Erandurthil/CNCproject/Original Design/README.md

# CNCproject
This is a Marlin-firmware based CNC machine
Has a sturdy design made from 3D printed parts and 20 x 20mm aluminum extrusions.
In combination with Nema 23 motors, and reliable custom Marlin firmware, this machine is very powerful.
