Erandurthil/CNCproject/Original Design/Buying List.xlsx

TOOLS |  |  | Different tools you will need (but might not need to buy)
Soldering iron |  |  | Soldering iron is required for most electronics
Multimeter |  |  | To controll voltages, connections and
5, 3, 2.5 and 1.5mm hex wrench |  |  | 5mm hex for M6 x 40/50 bolts, 3mm hex for M5 x 10 bolts, 2.5mm hex for M3 screws, 1.5 mm hex for grub screws
small flat head screwdriver |  |  | to fasten elecronics and more.
phillips head screwdriver |  |  | optional
6mm and 5mm drill bit |  |  | 6mm drillbit To drill holes in 20 x 20 aluminum extrusion for M6 x 50mm bolts. 5mm drillbit to drill holes in base plywood board for M5 screws screws.
Electronic Screwdriver |  |  | for use with 5 and 6mm drillbit
M6 tap |  |  | to tap M6 threads in the square section of 550mm 20 x 20mm aluminum extrusions
WHEN ASSEMBLING THE MACHINE
HIGH VOLTAGE!!! |  |  | Assemble everything before you connect any phase current to the electonics. Double check all connections with a multimeter.
Dont over tighten bolts and nuts |  |  | If bolts are over tightened 3D printed parts might crack!
Patience |  |  | A lot a waiting and focus is required.
Determiation |  |  | All will work out with determination.
Warm bevrage |  |  | Take a break. Don't work when you´re tired.
WHEN CUTTING WITH THE MACHINE
Hearing protection |  |  | For extended working sessions <10 minutes always wear hearing protection or you might damage your hearing
Eye protection |  |  | Being close to the machine increases the risk of dangerous debris damaging your eyes, very important when working with aluminum.
Protective gloves |  |  | When your cut is done you will want to remove your part carefully in order to avoid potential splinters from the working material.
Vaccum cleaner |  |  | to capture dust and splinters when cutting.
PARTS
Component | Amount | Amount of items | Used on the machine… |  | Suggested Seller/Website EU | Price/item | Sum
 | from link | on used the machine
FRAME
20x20mm aluminum extrusion 550mm | 6 | 6 | Frame, two parallell with the Y axis, four parallell with X axis like a ladder |  | https://www.banggood.com/Machifit-Black-2020-V-Slot-Aluminum-Profile-Extrusion-Frame-for-CNC-Laser-Engraving-Machine-p-1341703.html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 | 7.53 | 45.18
20x20mm aluminum extrusion 600mm | 2 | 2 | Mounts as support on the X axis gantry |  | https://www.banggood.com/Machifit-Black-2020-V-Slot-Aluminum-Profile-Extrusion-Frame-for-CNC-Laser-Engraving-Machine-p-1341703.html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 | 8.35 | 16.7
20x20mm aluminum extrusion 100mm | 4 | 4 | Legs to mount under the frame |  | https://www.banggood.com/Machifit-Black-2020-V-Slot-Aluminum-Profile-Extrusion-Frame-for-CNC-Laser-Engraving-Machine-p-1341703.html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 | 3.45 | 13.8
 |  |  |  |  |  |  | 0
MOVEMENT |  |  |  |  |  |  | 0
Nema 23 stepper motor | 1 | 3 | Two drive the Y axis, one drives the X axis. 3A motor is preferable over lower current variants. |  | https://www.amazon.de/-/en/Stepperonline-Pieces-Stepper-Bipolar-Printers/dp/B07CPP9RDP | 75 | 75
Nema 17 stepper motor | 1 | 1 | Drives Z axis through bevel gears |  | https://www.amazon.de/Usongshine-Stepper-Motor-1-8%C2%B04-Printer/dp/B07GLMGQB3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 | 10.98 | 10.98
600mm Leadscrew (8mm lead, 2mm pitch) | 2 | 2 | Used with nema 23 steppers to drive the Y axis |  | https://www.amazon.de/-/en/SIENOC-100-000-3D-Printer-Type/dp/B07LDZF2YR | 13.99 | 27.98
700mm Leadscrew (8mm lead, 2mm pitch) | 1 | 1 | Used with nema 23 stepper to drive the X axis |  | https://www.amazon.de/-/en/SIENOC-100-000-3D-Printer-Type/dp/B07LDZDBYV | 14.99 | 14.99
200mm Leadscrew (2mm lead, 2mm pitch) | 1 | 1 | Z axis leadscrew |  | https://www.amazon.de/-/en/WEJUANR-Printer-Lead-Screw-Pitch/dp/B08L98253X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 | 15.36 | 15.36
T8 Anti backlash nut (8mm lead, 2mm pitch) | 2 | 3 | Used to eliminate backlash in the machine. 3D printed parts are not designed to use included springs, |  | https://www.amazon.de/-/en/Dollatek-Spielfeder-Spring-Loaded-Elimination-Threaded/dp/B07DK58ZJP | 5.99 | 11.98
 |  |  | but the included nuts have tighter tolerances than those included with the (8mm lead) leadscrews |  |  |  | 0
Linear rail 200mm | 2 | 2 | Z axis linear movement, uses four linear blocks |  | https://www.banggood.com/Machifit-MGN12-100-1000mm-Linear-Rail-Guide-with-MGN12H-Linear-Sliding-Guide-Block-CNC-Parts-p-1156260.html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 | 13.49 | 26.98
Linear rail 600mm | 2 | 2 | X axis linear movement, uses four linear blocks |  | https://www.banggood.com/Machifit-MGN12-100-1000mm-Linear-Rail-Guide-with-MGN12H-Linear-Sliding-Guide-Block-CNC-Parts-p-1156260.html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 | 23.28 | 46.56
Linear rail 550mm | 2 | 2 | Y axis linear movement, uses four linear blocks |  | https://www.banggood.com/Machifit-MGN12-100-1000mm-Linear-Rail-Guide-with-MGN12H-Linear-Sliding-Guide-Block-CNC-Parts-p-1156260.html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 | 20.02 | 40.04
Linear block MGN12H | 6 | 6 | Additional linear blocks. One block is included with each linear rail mentioned above. 12 in total. |  | https://www.banggood.com/Machifit-MGN12-100-1000mm-Linear-Rail-Guide-with-MGN12H-Linear-Sliding-Guide-Block-CNC-Parts-p-1156260.html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 | 9.41 | 56.46
 |  |  |  |  |  |  | 0
ELECTRONICS |  |  |  |  |  |  | 0
ER11 500W Spindle and Power supply with speed governor | 1 | 1 | This is a very simple 500W Spindle which is used in this machine. Reliable and powerful enough for most materials. |  | https://www.banggood.com/Machifit-ER11-Chuck-CNC-500W-Spindle-Motor-with-52mm-Clamps-and-Power-Supply-Speed-Governor-p-1027937.html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 | 57.1 | 57.1
 |  |  | If you chose a different spindle for any reason the 3D printed 52mm clamp might not work. |  |  |  | 0
MKS GEN 1.4 motherboard | 1 | 1 | A reliable motherboard used with some 3D printers. Uses modified Marlin firmware. |  | https://www.amazon.de/-/en/Kingprint-Controller-Motherboard-RAMPS1-4-Compatible/dp/B079BZ1K3B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 | 29.99 | 29.99
TB6600 4A stepper motor driver | 4 | 4 | Takes power supply current and signals from MKS GEN 1.4 motherboard in order to drive all stepper motors |  | https://www.amazon.de/-/en/Haljia-TB6600-Stepper-Driver-Controller/dp/B06XQGHXL3 | 14.99 | 59.96
Mechanical endstops | 1 | 4 | The product linked has the correct dimensions for the 3D printed parts. |  | https://www.amazon.de/Longruner-Monitor-Display-Raspberry-Various/dp/B071J2RSY7 | 9.99 | 9.99
24V power supply | 1 | 1 | Provides current to the motherboard and the stepper motor drivers. 24V is preferable over 12V PSU |  | https://www.amazon.de/-/en/transformer-Meanwell-150-24-Inch-Switching-Transformer/dp/B00UCXHV6G | 20.68 | 20.68
80x80mm 24V/12V/5V fan | 1 | 1 | For cooling the enclosed motherboard. Buy two fans if you want to additional cooling to TB6600 drivers (Optional). |  | https://www.amazon.de/-/en/Sunon-MF80252V11000UA99-Fan-1-56-69-6/dp/B07ZBSD3HG | 8.87 | 8.87
C14 Appliance connector | 1 | 1 | A safe connector for mains current to connect to the machine. Size and dimensions may vary. |  | No link. Buy from local hardware store |  | 0
C14 Plug cable | 1 | 1 | A safe cable to connect to power outlet. 3m long. |  | No link. Buy from local hardware store |  | 0
 |  |  |  |  |  |  | 0
EXTRA CABLES |  |  | Some of the products include wires for motors and sensors, but extra wires are needed to complete the machine. |  |  |  | 0
3d Printer cable 4 pin-4 pin | 2 | 8m | Used to connect motors and sensors to the MKS GEN 1.4 board and the stepper motor drivers. Soldering is required. |  | https://www.amazon.de/-/en/UEETEK-Bipolar-Stepper-Printer-Machines/dp/B0711Z3RXJ | 6.99 | 13.98
Spindle motor cable | 0 | 4m | Any diameter cable larger or the size of the red and black spindle motor wires. |  | No link. Buy from local hardware store |  | 0
Cable management dragchains | 2 | 2m | Used to manage cables parallell to the X and Y axis. |  | https://www.amazon.de/-/en/Carrier-Energy-Printer-Router-Machine/dp/B07LDCQTBN | 9.59 | 19.18
 |  |  |  |  |  |  | 0
FASTNERS AND SCREWS |  |  |  |  |  |  | 0
M5 T-slot nut | 1 | ~50 | Used with bolts to fasten 3D printed parts to 20x20 aluminum extrusions |  | https://www.banggood.com/Drillpro-100pcs-M5-Hammer-Nut-Nickel-Plated-Carbon-Steel-Aluminum-Connector-T-Fastener-Sliding-Nut-p-1048442.html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 | 6.05 | 6.05
M5 x 10mm bolt | 1 | ~50 | Used with M5 T-slot nuts |  | https://www.banggood.com/Suleve-M5SH6-50Pcs-M5-Stainless-Steel-Hex-Socket-Button-Head-Screw-Bolt-8-30mm-Optional-Length-p-1333438.html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 | 4.48 | 4.48
M3 x 8mm bolt |  | 32 | Used with M3 T-slot nuts |  |  | 3.26 | 0
M3 T-slot nut | 1 | 32 | Used to fasten linear rails to 20x20 aluminum extrusions |  | https://www.banggood.com/Drillpro-50pcs-M3-T-Sliding-Nut-Zinc-Plated-Carbon-Steel-T-Sliding-Nut-for-2020-Aluminum-Profile-p-1081131.html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 | 5.38 | 5.38
M3 Square nut | 2 | ~30 | Used with 10/16/25mm M3 bolts to connect different 3D printed parts |  | https://www.amazon.de/-/en/SECCARO-Square-Stainless-Steel-Form/dp/B07NQN15KT?s=diy | 8.95 | 17.9
M3 x 10/16/25mm bolt | 1 | ~30 of each length | Used with square nuts | ALL M3 BOLTS YOU WILL NEED >>> | https://www.amazon.de/-/en/VIGRUE-Pack-1110-Screws-Washers/dp/B083R4PKBW | 26.99 | 26.99
M6 x 50mm bolt |  | 4 | To mount Y axis brackets to the frame M6 thread tapping required |  | No link. Buy from local hardware store
M6 x 40mm bolt |  | 4 | To mount X gantry extrusion clamp to 3D printed parts |  | No link. Buy from local hardware store
M6 nut |  | 4 | Used with M6 x 40 bolts |  | No link. Buy from local hardware store
M5 x 20mm bolt |  | 10 | Used to fasten Nema 23 motors to 3D printed parts |  | No link. Buy from local hardware store
M5 nut |  | 10 | Used with M5 x 20mm bolts |  | No link. Buy from local hardware store
M3 x 5mm grub screws |  | 12 | Used with 3D printed motor couplers and M3 square nuts to fasten Leadscrews to Nema 23 motors |  | No link. Buy from local hardware store
 |  |  |  |  |  |  | 682.56 | €
