Erandurthil/CNCproject/New Design/Printed Parts/Printed parts/Frame/System20_Bracket_20mm.stl

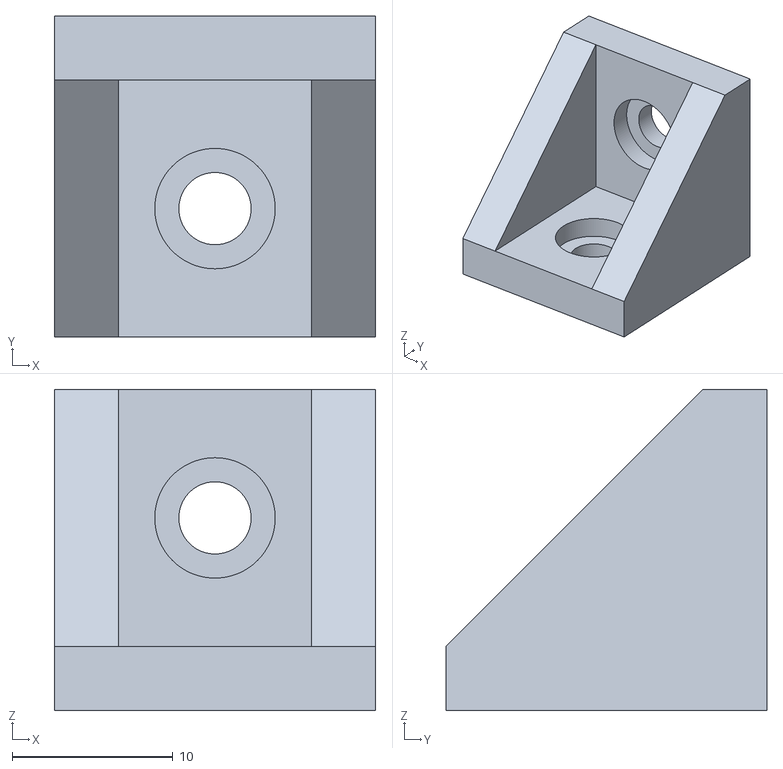
[picture p1: CAD file, 2021-01-12]
New Design/Printed Parts/Printed parts/Frame/System20_Bracket_20mm.stl
20.0 x 20.0 x 20.0
