Erandurthil/CNCproject/New Design/Printed Parts/Printed parts/X-axis/X_Z_MountingPlate.stl

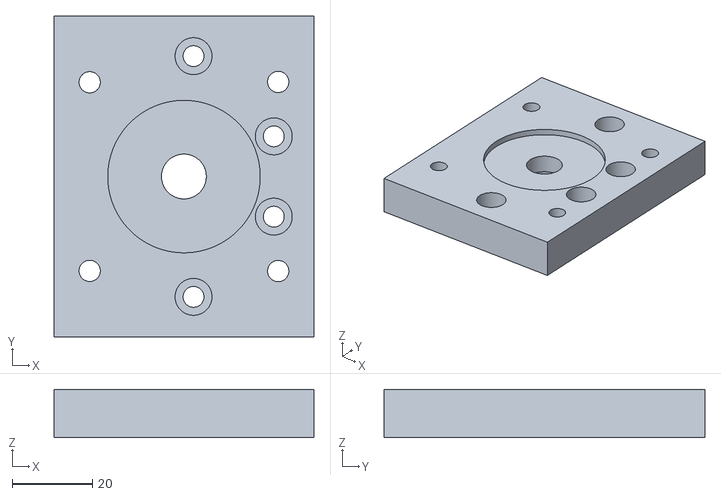
[picture p2: CAD file, 2021-02-13]
New Design/Printed Parts/Printed parts/X-axis/X_Z_MountingPlate.stl
64.8 x 80.0 x 12.0
