Erandurthil/CNCproject/New Design/Printed Parts/Printed parts/Y-axis/Y-axis Left side/Endstop_cover_L.stl

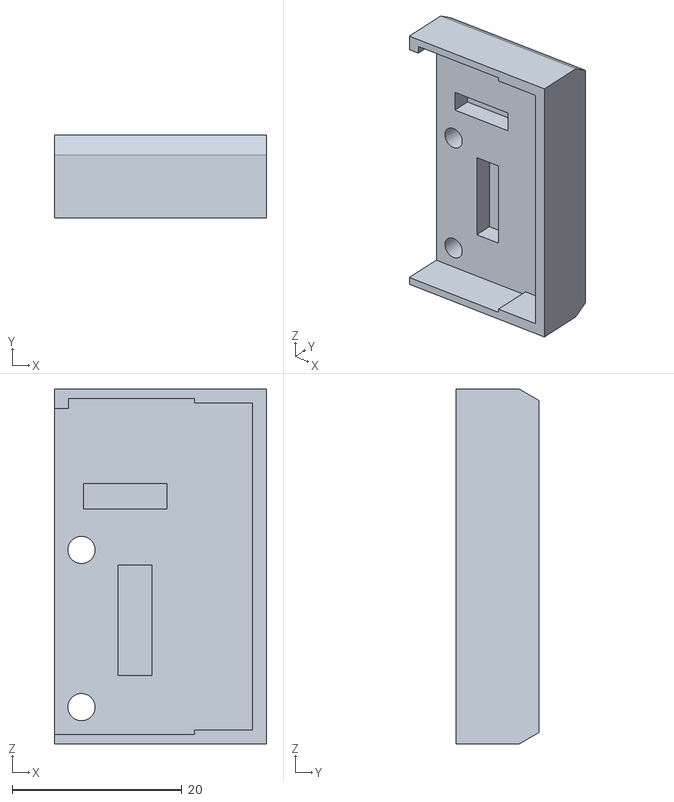
[picture p3: CAD file, 2021-02-13]
New Design/Printed Parts/Printed parts/Y-axis/Y-axis Left side/Endstop_cover_L.stl
25.0 x 9.80 x 41.8
