Erandurthil/CNCproject/New Design/Printed Parts/Printed parts/Y-axis/Y-axis Right side/Y_axis_front _bracket_R.stl

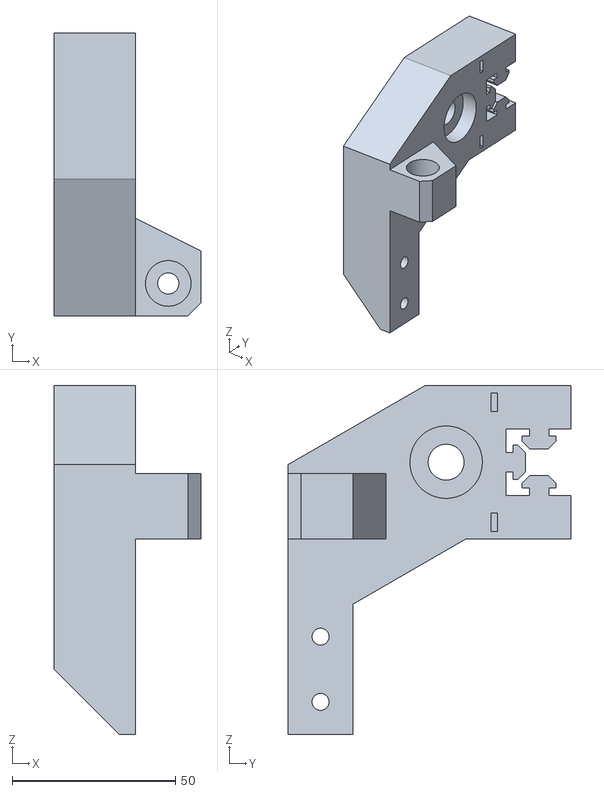
[picture p4: CAD file, 2021-02-13]
New Design/Printed Parts/Printed parts/Y-axis/Y-axis Right side/Y_axis_front _bracket_R.stl
45.0 x 86.8 x 107.0
