Erandurthil/CNCproject/New Design/Printed Parts/Printed parts/X-axis/Mounting Plate.stl

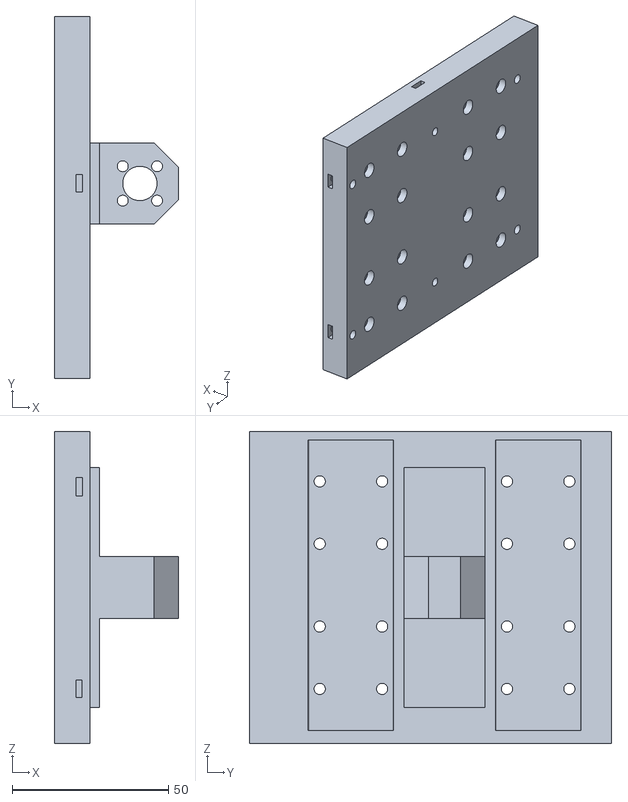
[picture p5: CAD file, 2021-02-12]
New Design/Printed Parts/Printed parts/X-axis/Mounting Plate.stl
39.8 x 116.0 x 100.0
