Erandurthil/CNCproject/New Design/Printed Parts/Printed parts/Y-axis/Y-axis Left side/Y_axis_motor_bracket_L.stl

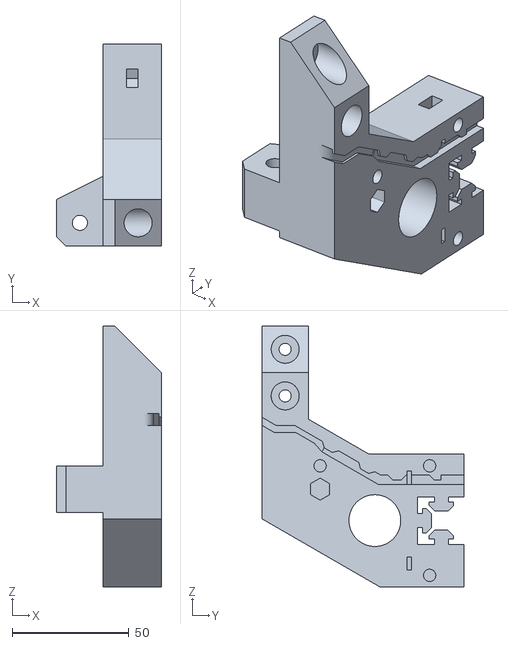
[picture p6: CAD file, 2021-02-13]
New Design/Printed Parts/Printed parts/Y-axis/Y-axis Left side/Y_axis_motor_bracket_L.stl
45.0 x 86.8 x 112.0
