Erandurthil/CNCproject/New Design/Printed Parts/Printed parts/Z-axis/5mm_D_shaft_bevel_gear.stl

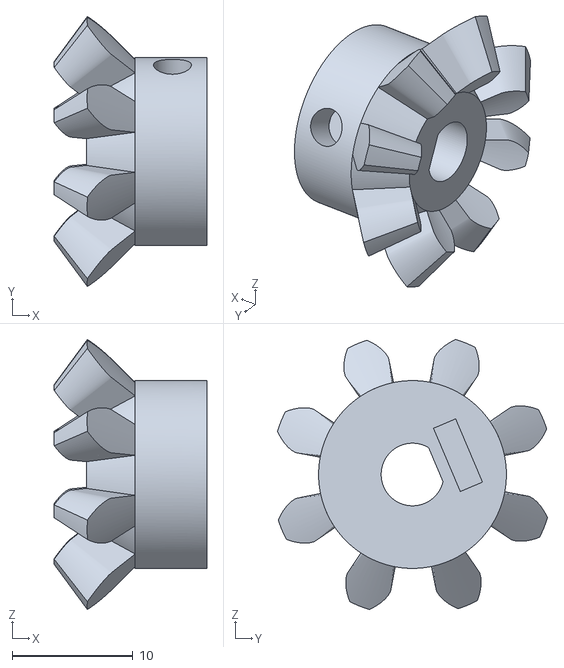
[picture p7: CAD file, 2021-01-12]
New Design/Printed Parts/Printed parts/Z-axis/5mm_D_shaft_bevel_gear.stl
12.7 x 22.4 x 22.4
