Erandurthil/CNCproject/New Design/Printed Parts/Printed parts/X-axis/X_axis_gantry_L.stl

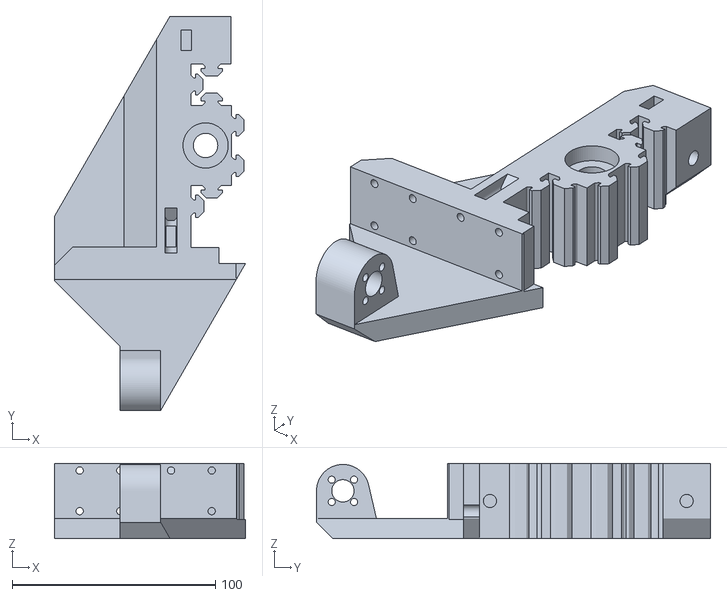
[picture p8: CAD file, 2021-01-12]
New Design/Printed Parts/Printed parts/X-axis/X_axis_gantry_L.stl
94.2 x 194.0 x 37.0
