Erandurthil/CNCproject/New Design/Printed Parts/Printed parts/Y-axis/Y-axis Left side/Y_axis_front_bracket_clamp.stl

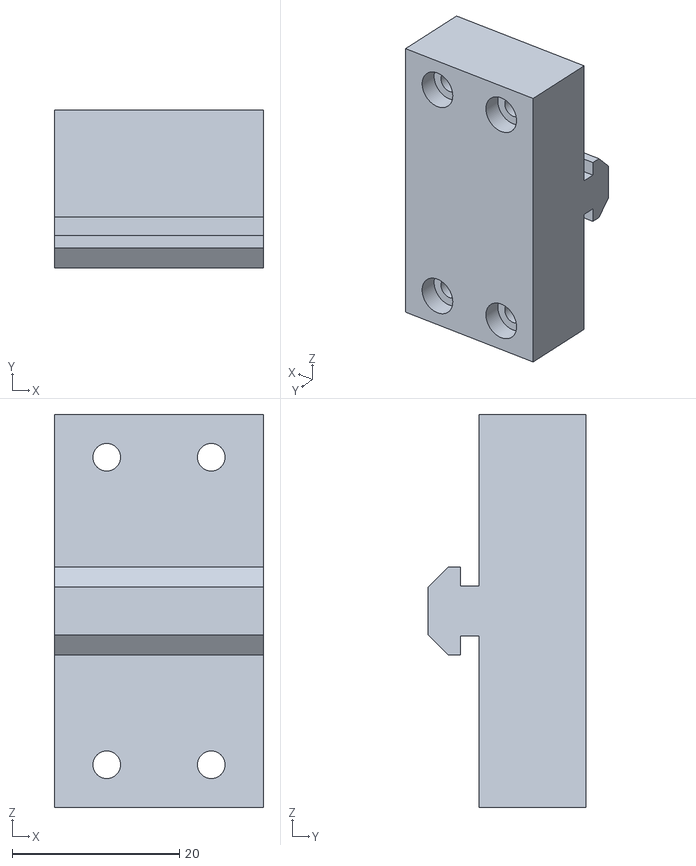
[picture p9: CAD file, 2021-02-13]
New Design/Printed Parts/Printed parts/Y-axis/Y-axis Left side/Y_axis_front_bracket_clamp.stl
25.0 x 18.9 x 47.0
