Erandurthil/CNCproject/New Design/Printed Parts/Printed parts/X-axis/Extrusion_clamp_R.stl

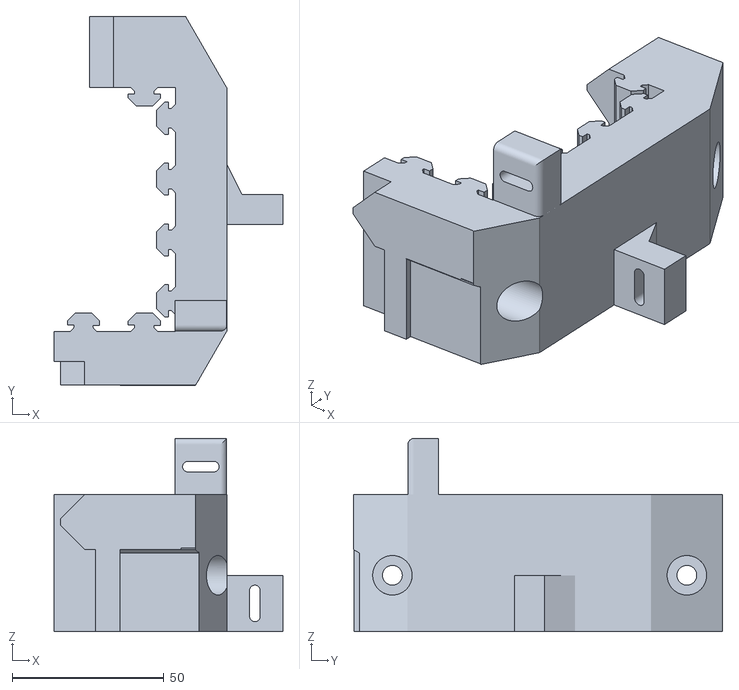
[picture p10: CAD file, 2021-01-12]
New Design/Printed Parts/Printed parts/X-axis/Extrusion_clamp_R.stl
75.3 x 121.4 x 63.5
