Erandurthil/CNCproject/New Design/Printed Parts/Printed parts/Y-axis/Y-axis Right side/Y_axis_motor_bracket_clamp_R.stl

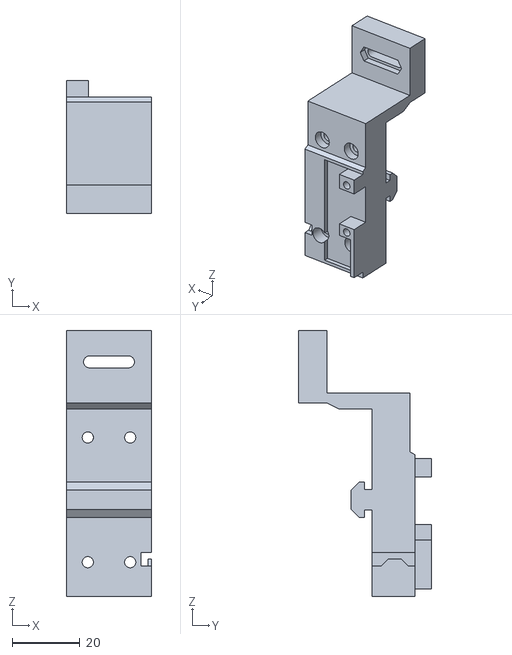
[picture p11: CAD file, 2021-02-13]
New Design/Printed Parts/Printed parts/Y-axis/Y-axis Right side/Y_axis_motor_bracket_clamp_R.stl
25.0 x 39.2 x 78.4
