Erandurthil/CNCproject/New Design/Printed Parts/Printed parts/Z-axis/Z_axis_motor_mount.stl

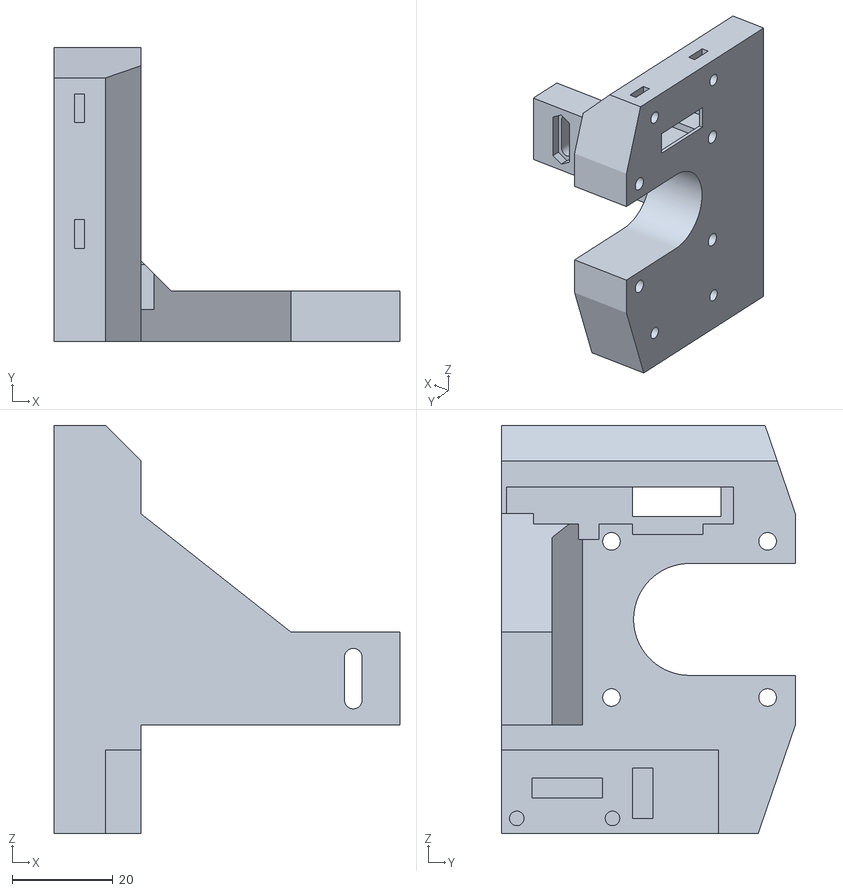
[picture p12: CAD file, 2021-01-12]
New Design/Printed Parts/Printed parts/Z-axis/Z_axis_motor_mount.stl
68.6 x 58.3 x 81.0
