Erandurthil/CNCproject/New Design/Printed Parts/Printed parts/X-axis/Extrusion_clamp_L.stl

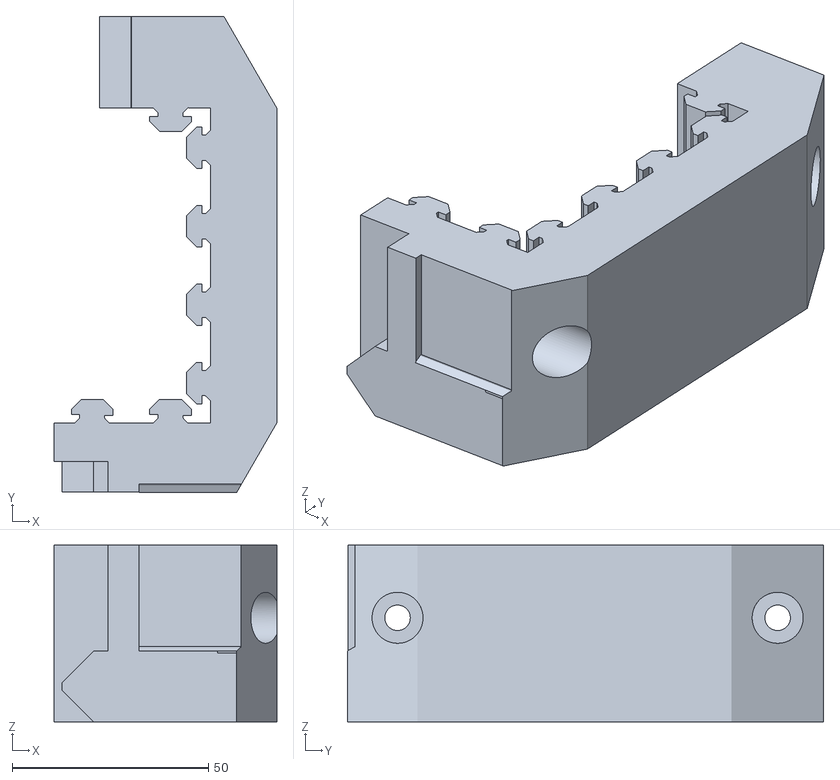
[picture p13: CAD file, 2021-01-12]
New Design/Printed Parts/Printed parts/X-axis/Extrusion_clamp_L.stl
56.8 x 121.4 x 45.0
