Erandurthil/CNCproject/New Design/Printed Parts/Printed parts/Y-axis/Y-axis Left side/Y_axis_motor_bracket_clamp_L.stl

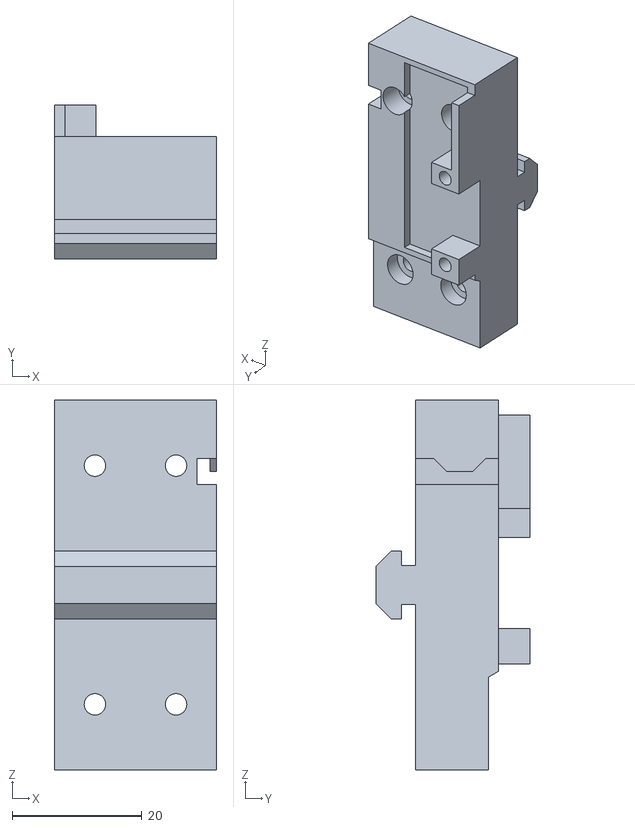
[picture p14: CAD file, 2021-02-13]
New Design/Printed Parts/Printed parts/Y-axis/Y-axis Left side/Y_axis_motor_bracket_clamp_L.stl
25.0 x 23.7 x 57.0
