Erandurthil/CNCproject/New Design/Printed Parts/Printed parts/Z-axis/Spindle_motor_mount.stl

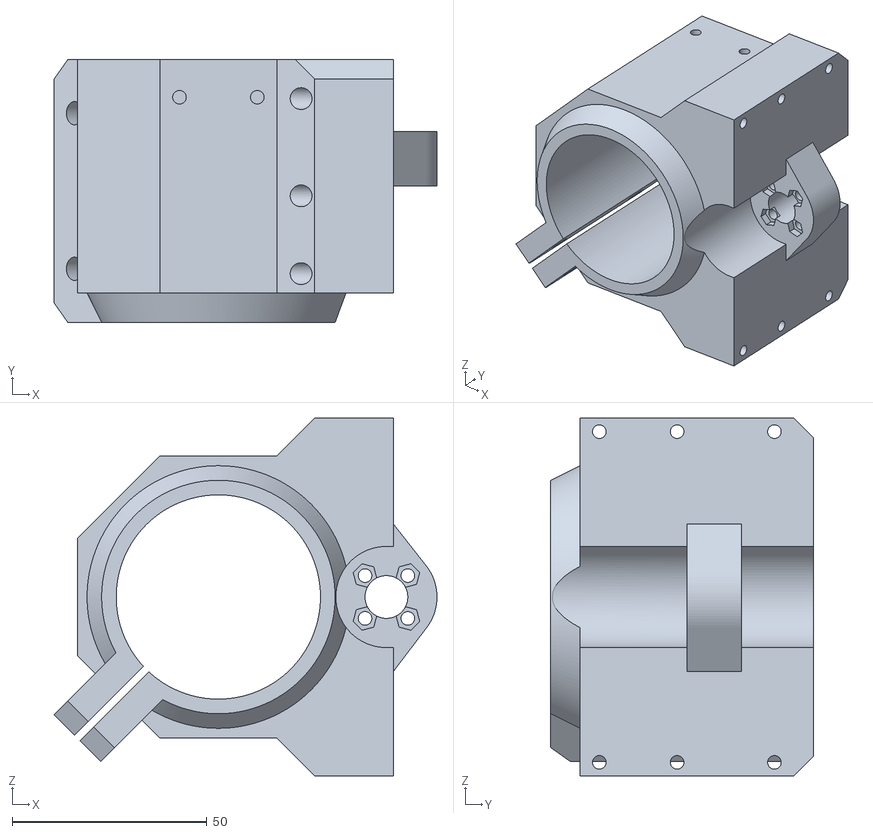
[picture p15: CAD file, 2021-01-12]
New Design/Printed Parts/Printed parts/Z-axis/Spindle_motor_mount.stl
98.4 x 67.5 x 92.0
