Erandurthil/CNCproject/New Design/Printed Parts/Printed parts/Y-axis/Y-axis Left side/Y_axis_spacer_L.stl

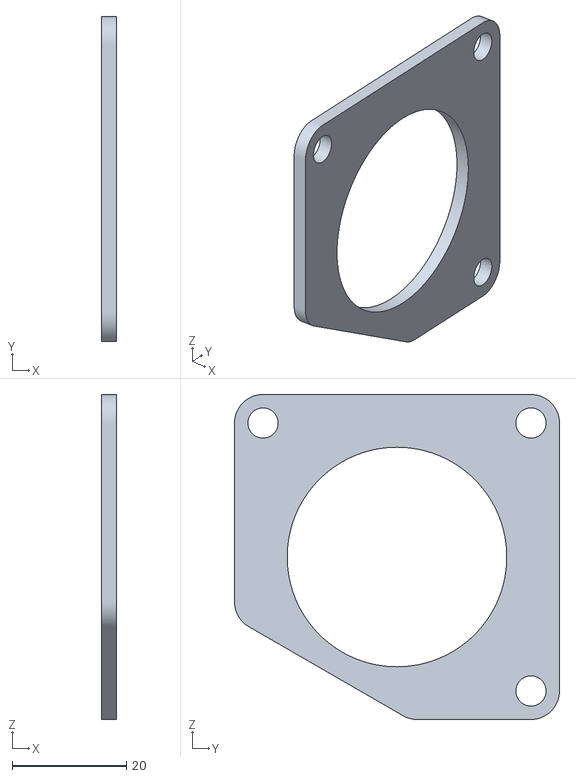
[picture p16: CAD file, 2021-01-12]
New Design/Printed Parts/Printed parts/Y-axis/Y-axis Left side/Y_axis_spacer_L.stl
2.60 x 57.0 x 57.0
