Erandurthil/CNCproject/(list of files, cad)

Other CAD files:
New Design/Printed Parts/Printed parts/Y-axis/Y-axis Right side/Endstop_cover_R.stl
New Design/Printed Parts/Printed parts/Y-axis/Y-axis Right side/Y_axis_motor_bracket_R.stl
New Design/Printed Parts/Printed parts/Y-axis/Y-axis Left side/Y_axis_front_bracket_L.stl
New Design/Printed Parts/Printed parts/Y-axis/Y-axis Right side/Y_axis_front_bracket_clamp.stl
New Design/Printed Parts/Printed parts/X-axis/X_axis_gantry_R.stl
New Design/Printed Parts/Printed parts/Y-axis/Y-axis Right side/Y_axis_spacer_R.stl
New Design/Printed Parts/Printed parts/Misc/6,35-8mm_leadscrew_motor_coupler.stl
New Design/Printed Parts/Printed parts/Z-axis/8mm_trapezoidal_leadscrew bevel_gear.stl
New Design/Printed Parts/Printed parts/Z-axis/Z_axis_leadscrew_block.stl
New Design/Printed Parts/Printed parts/Z-axis/Z_axis_leadscrew_stabilizer.stl
