Erandurthil/CNCproject/New Design/Printed Parts/Printed parts/X-axis/Printing instructions.txt

see google sheet
https://docs.google.com/spreadsheets/d/1e_pDhpXo8OFGgLAYwlkPzqQZTda7yinpnChNd7s-tAU/edit#gid=643387770
