Erandurthil/CNCproject/New Design/Printed Parts/Printed parts/Y-axis/Y-axis Left side/Printing instructions.txt

see google sheets
https://docs.google.com/spreadsheets/d/1e_pDhpXo8OFGgLAYwlkPzqQZTda7yinpnChNd7s-tAU/edit#gid=643387770
