Erandurthil/CNCproject/New Design/Firmware/Marlin-2.0.x-Router/Marlin-2.0.x/Marlin/Configuration_adv.h

#define E0_AUTO_FAN_PIN -1
#define E1_AUTO_FAN_PIN -1
#define E2_AUTO_FAN_PIN -1
#define E3_AUTO_FAN_PIN -1
#define E4_AUTO_FAN_PIN -1
#define E5_AUTO_FAN_PIN -1
#define E6_AUTO_FAN_PIN -1
#define E7_AUTO_FAN_PIN -1
#define CHAMBER_AUTO_FAN_PIN -1
#define Y_DUAL_STEPPER_DRIVERS
  #define Y_DUAL_ENDSTOPS
#define HOMING_BUMP_MM      { 3, 3, 1 }       // (mm) Backoff from endstops after first bump
#define HOMING_BUMP_DIVISOR { 2, 2, 2 }       // Re-Bump Speed Divisor (Divides the Homing Feedrate)
#define HOMING_BACKOFF_POST_MM { 5, 5, 2 }  // (mm) Backoff from endstops after homing
#define HOME_Z_FIRST                        // Home Z first. Requires a Z-MIN endstop (not a probe).
#define MICROSTEP_MODES { 16, 16, 16, 16, 16, 16 } // [1,2,4,8,16]
    #define Z_CURRENT       1000
    #define Z_CURRENT_HOME  Z_CURRENT
    #define Z_MICROSTEPS     16
  #define X_HYBRID_THRESHOLD     100  // [mm/s]
  #define X2_HYBRID_THRESHOLD    100
  #define Y_HYBRID_THRESHOLD     100
  #define Y2_HYBRID_THRESHOLD    100
  #define Z_HYBRID_THRESHOLD       3
  #define Z2_HYBRID_THRESHOLD      3
  #define Z3_HYBRID_THRESHOLD      3
  #define Z4_HYBRID_THRESHOLD      3
  #define E0_HYBRID_THRESHOLD     30
  #define E1_HYBRID_THRESHOLD     30
  #define E2_HYBRID_THRESHOLD     30
  #define E3_HYBRID_THRESHOLD     30
  #define E4_HYBRID_THRESHOLD     30
  #define E5_HYBRID_THRESHOLD     30
  #define E6_HYBRID_THRESHOLD     30
  #define E7_HYBRID_THRESHOLD     30
