Erandurthil/CNCproject/(commit log)

2021-01-12 update STLs for our version
    [5mm_D_shaft_bevel_gear.stl, 6,35-8mm_leadscrew_motor_coupler.stl, 8mm_trapezoidal_leadscrew bevel_gear.stl, Buying List.xlsx, Endstop_cover_L.stl, Endstop_cover_R.stl, Extrusion_clamp_L.stl, Extrusion_clamp_R.stl]
2021-01-12 added 2020 corner angle things
    [System20_Bracket_20mm.stl]
2021-01-17 fixed Y bracket missing holes
    [Y_axis_front _bracket_R.stl, Y_axis_front_bracket_clamp.stl, Y_axis_motor_bracket_L.stl, Y_axis_motor_bracket_R.stl]
2021-02-12 fixed some stl's
    [Mounting Plate.stl, X_Z_MountingPlate.stl]
2021-02-13 refactored the general frame mounts,bad original design
    [Endstop_cover_L.stl, Endstop_cover_R.stl, X_Z_MountingPlate.stl, X_axis_motor_mounting_plate.stl, Y_axis_front _bracket_R.stl, Y_axis_front_bracket_L.stl, Y_axis_front_bracket_clamp.stl, Y_axis_motor_bracket_L.stl]
2021-02-23 V4 finished
    [5mm_D_shaft_bevel_gear.stl, 6,35-8mm_leadscrew_motor_coupler.stl, 8mm_trapezoidal_leadscrew bevel_gear.stl, Configuration.h, Configuration_adv.h, Endstop_cover_L.stl, Endstop_cover_R.stl, Extrusion_clamp_L.stl]
